kaku-san/PROBE-LX-3/docs/images/social-preview.png

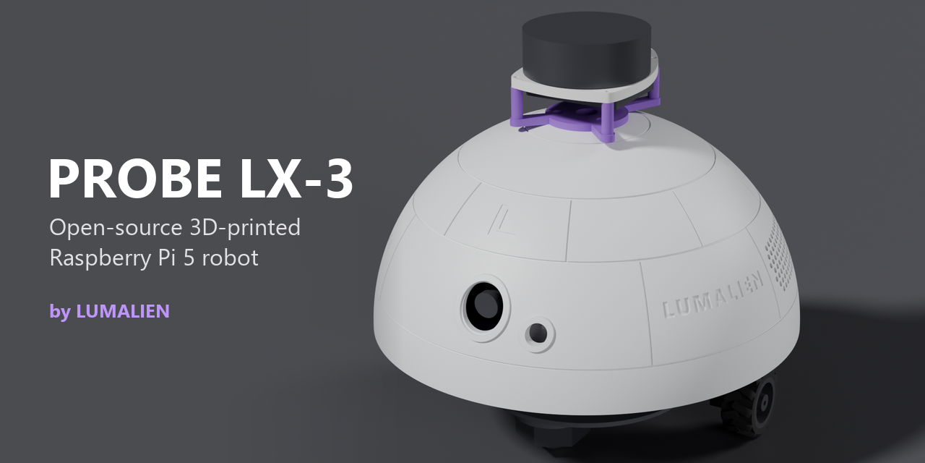
docs/images/social-preview.png
