kaku-san/PROBE-LX-3/hardware/pi5-skid/ROVER_REMAINING_5_PARTS_CHECKED.3mf

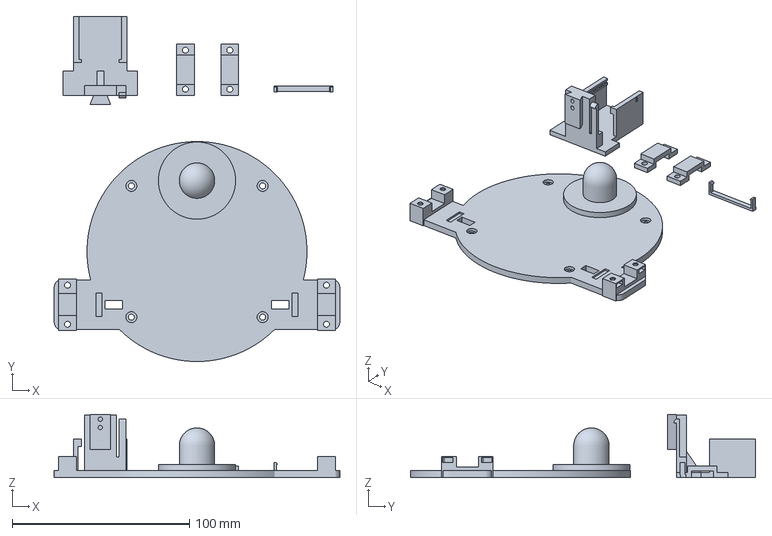
[picture p7: CAD file, 2026-11-10]
hardware/pi5-skid/ROVER_REMAINING_5_PARTS_CHECKED.3mf
161.0 x 194.5 x 35.6 mm
