kaku-san/PROBE-LX-3/hardware/pi5-skid/stl/PROBE-LX3_drive-plate_N20_SKID_CANDIDATE.stl

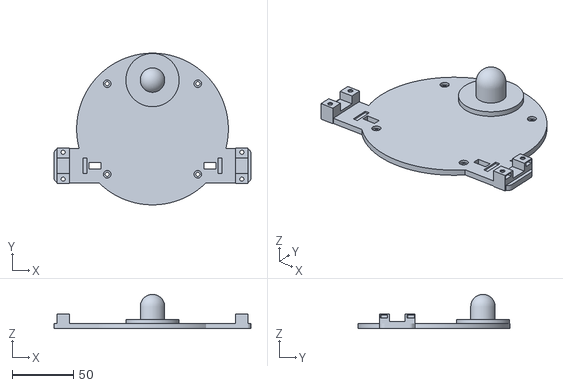
[picture p8: CAD file, 2026-11-10]
hardware/pi5-skid/stl/PROBE-LX3_drive-plate_N20_SKID_CANDIDATE.stl
161.0 x 124.0 x 28.0
