kaku-san/PROBE-LX-3/stl/PROBE-LX3_wheel-hub.stl

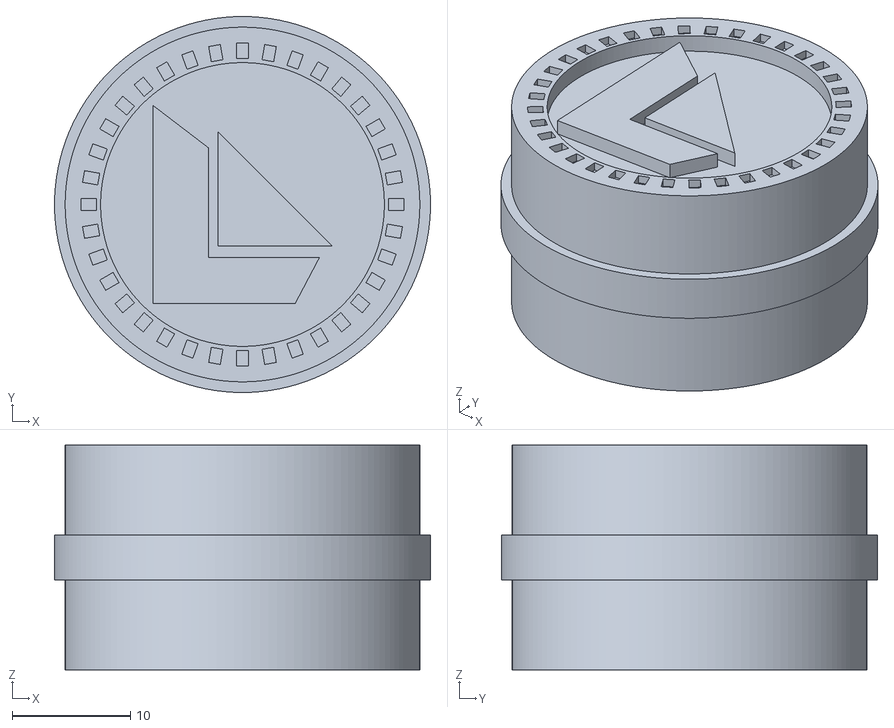
[picture p9: CAD file, 2026-09-24]
stl/PROBE-LX3_wheel-hub.stl
31.8 x 31.8 x 19.0
