kaku-san/PROBE-LX-3/hardware/pi5-skid/stl/N20_CAP_print_two.stl

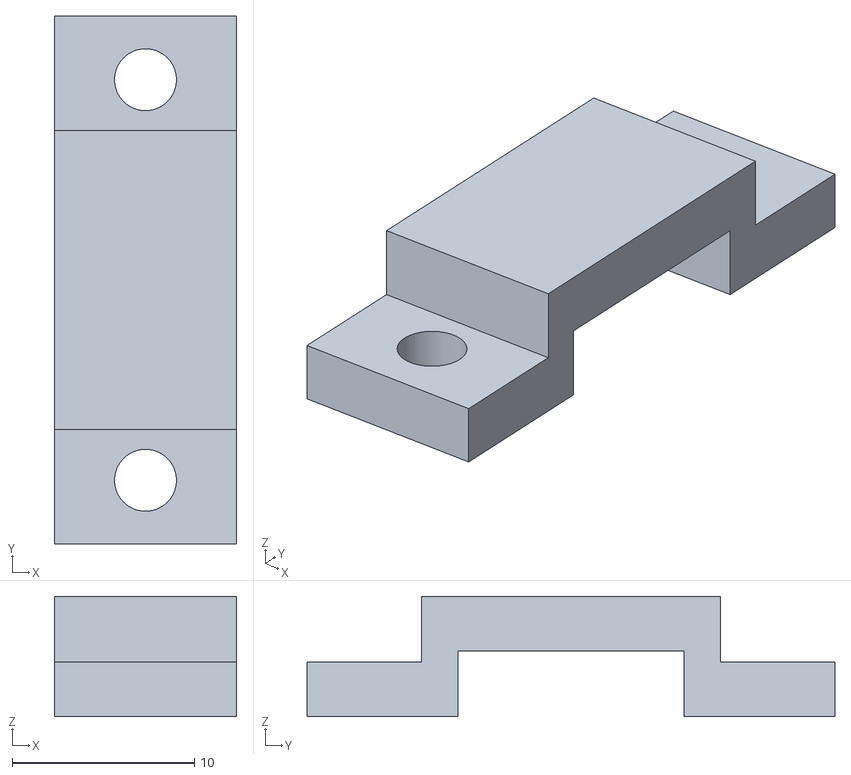
[picture p10: CAD file, 2026-11-10]
hardware/pi5-skid/stl/N20_CAP_print_two.stl
10.0 x 29.0 x 6.60
