kaku-san/PROBE-LX-3/stl/PROBE-LX3_wheel-tyre.stl

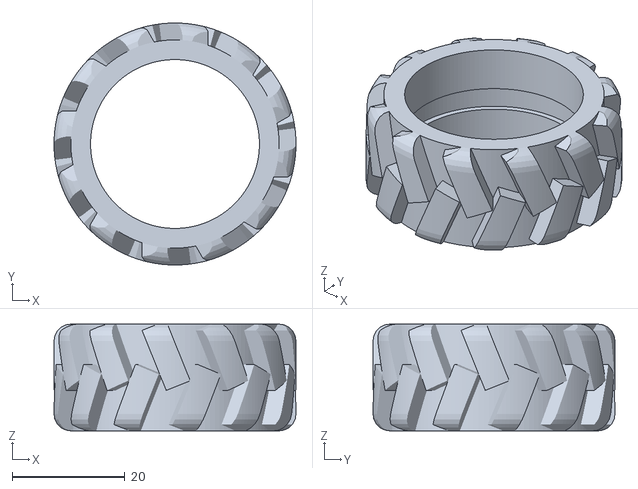
[picture p11: CAD file, 2026-09-24]
stl/PROBE-LX3_wheel-tyre.stl
43.0 x 43.0 x 19.0
