kaku-san/PROBE-LX-3/hardware/pi5-skid/stl/CAMERA_KEEPER_CANDIDATE.stl

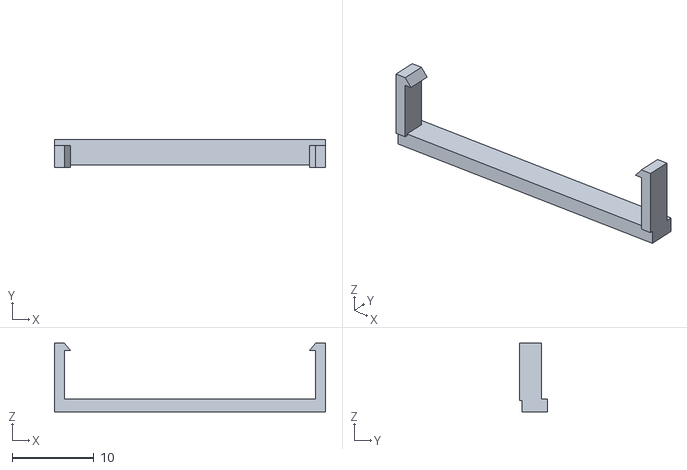
[picture p12: CAD file, 2026-11-10]
hardware/pi5-skid/stl/CAMERA_KEEPER_CANDIDATE.stl
33.1 x 3.40 x 8.40
