kaku-san/PROBE-LX-3/stl/PROBE-LX3_lidar-adapter_optional.stl

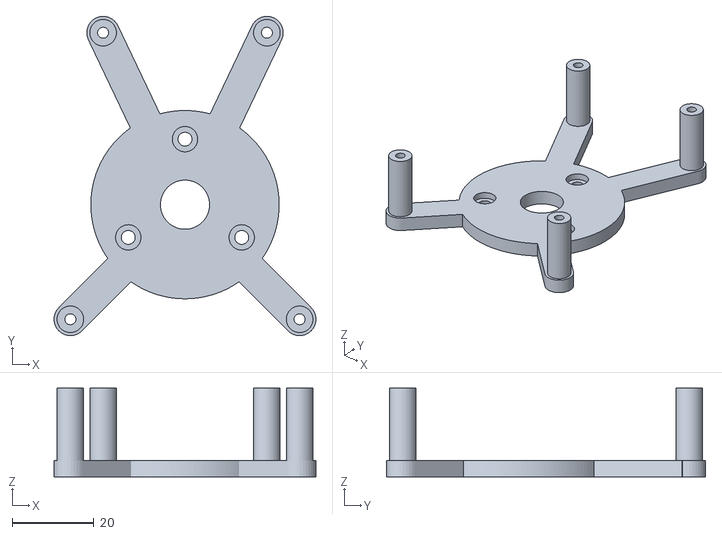
[picture p13: CAD file, 2026-09-24]
stl/PROBE-LX3_lidar-adapter_optional.stl
64.0 x 78.0 x 21.7
