kaku-san/PROBE-LX-3/hardware/pi5-skid/stl/CAMERA_CARRIER_CANDIDATE.stl

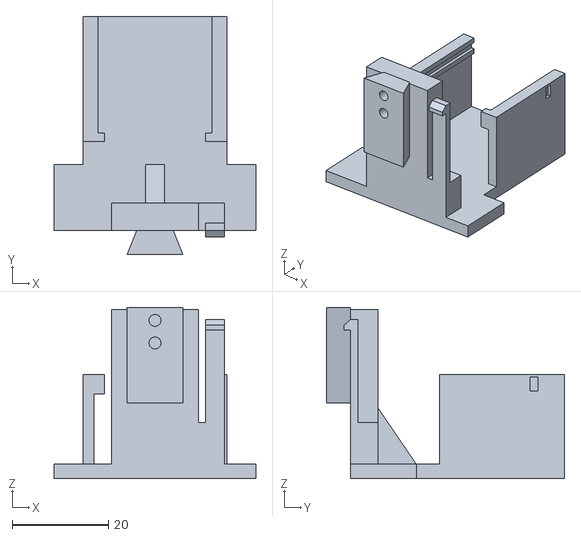
[picture p14: CAD file, 2026-11-10]
hardware/pi5-skid/stl/CAMERA_CARRIER_CANDIDATE.stl
42.0 x 49.5 x 35.6
