kaku-san/PROBE-LX-3/stl/PROBE-LX3_drive-plate.stl

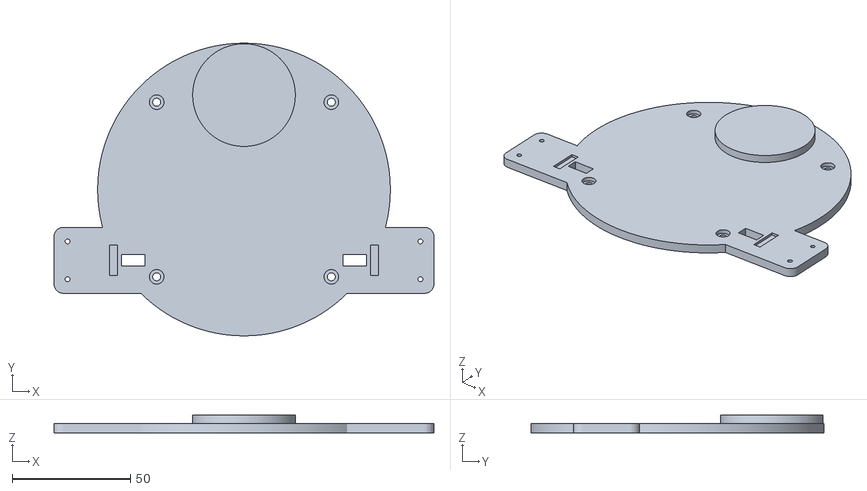
[picture p15: CAD file, 2026-09-24]
stl/PROBE-LX3_drive-plate.stl
161.0 x 124.0 x 7.50
