kaku-san/PROBE-LX-3/stl/PROBE-LX3_electronics-tray.stl

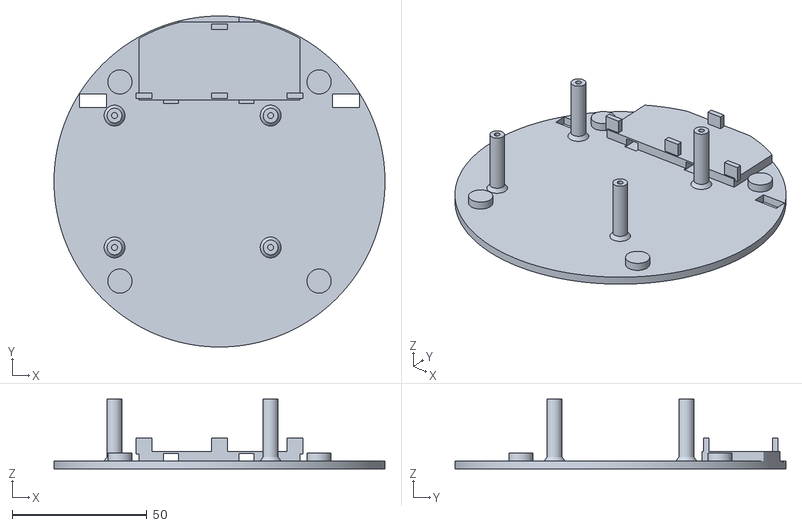
[picture p16: CAD file, 2026-09-24]
stl/PROBE-LX3_electronics-tray.stl
123.0 x 123.0 x 26.0
