kaku-san/PROBE-LX-3/stl/PROBE-LX3_dome.stl

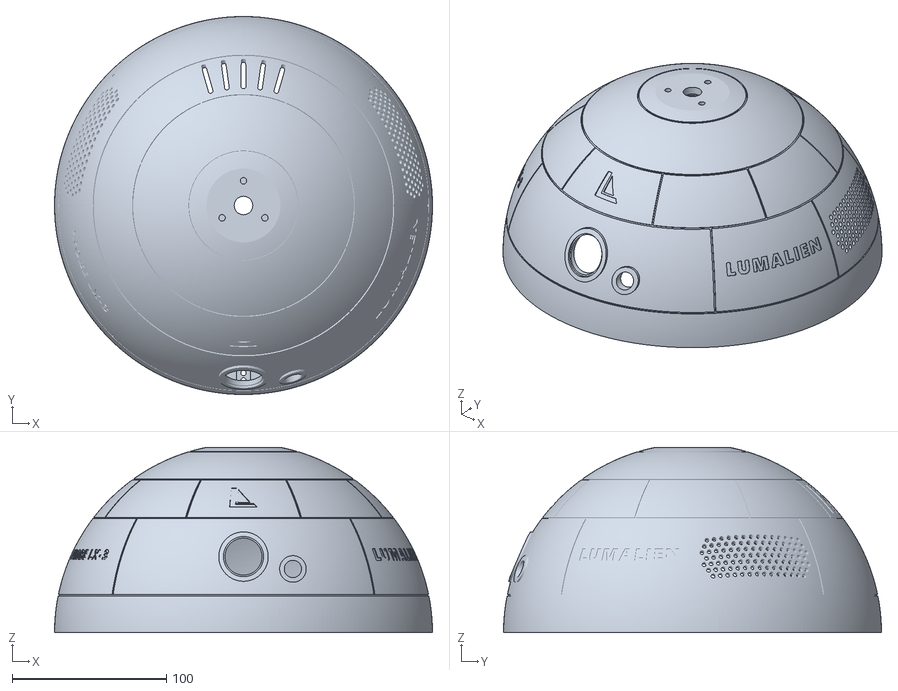
[picture p17: CAD file, 2026-09-24]
stl/PROBE-LX3_dome.stl
244.8 x 244.8 x 120.0
