kaku-san/PROBE-LX-3/stl/PROBE-LX3_base.stl

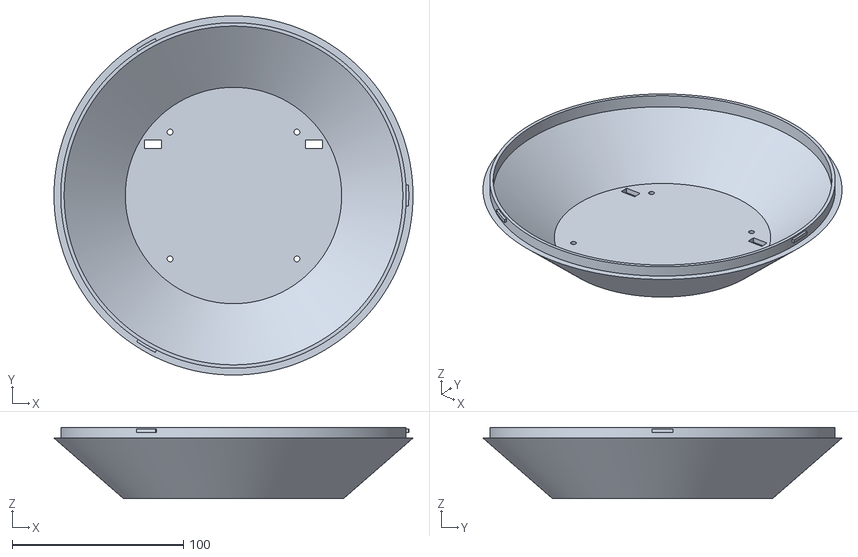
[picture p18: CAD file, 2026-09-24]
stl/PROBE-LX3_base.stl
209.4 x 209.4 x 41.5
