kaku-san/PROBE-LX-3/stl/PROBE-LX3_camera-bracket.stl

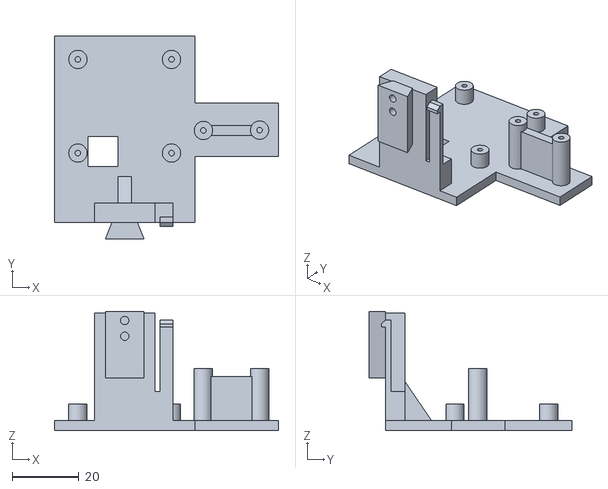
[picture p19: CAD file, 2026-09-24]
stl/PROBE-LX3_camera-bracket.stl
67.0 x 60.7 x 35.6
