kaku-san/PROBE-LX-3/(list of files, cad)

Other CAD files:
cad/PROBE-LX-3.blend
