kaku-san/PROBE-LX-3/docs/build-images/assembly-01-motors.png

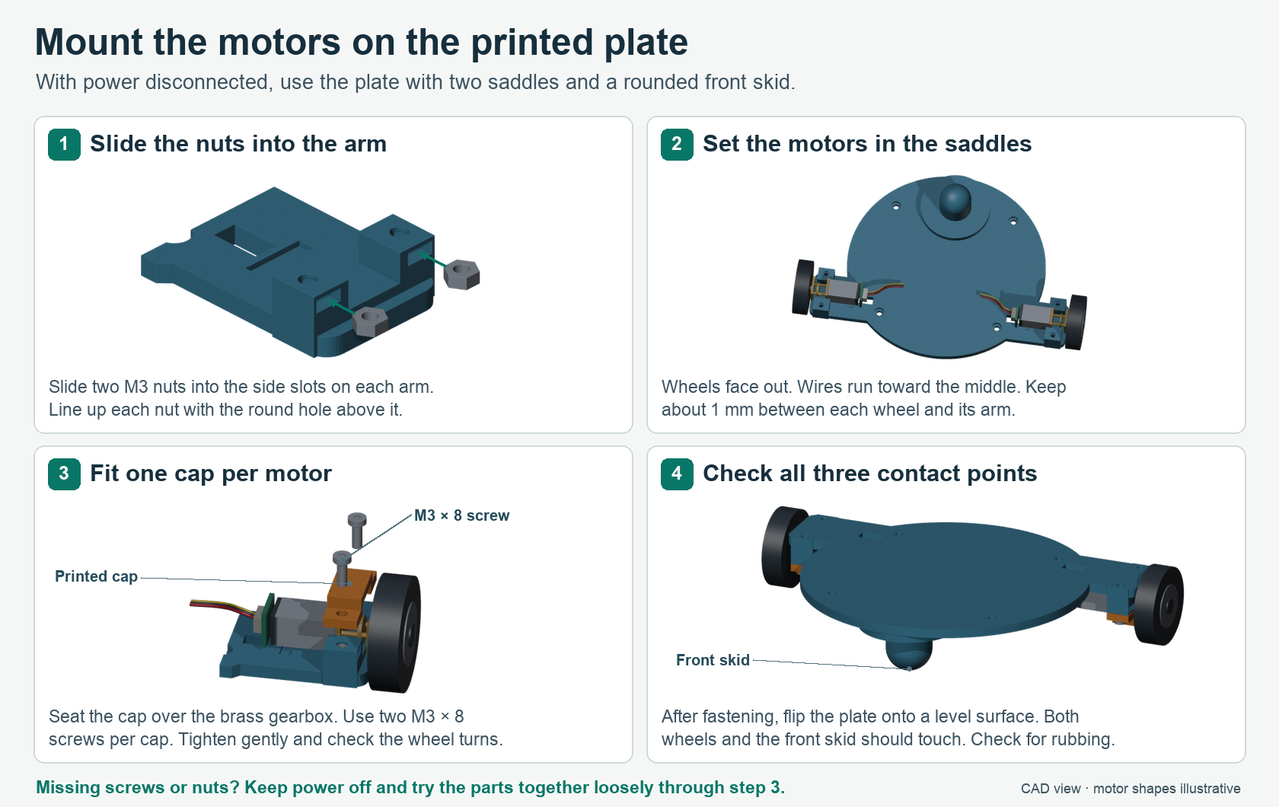
docs/build-images/assembly-01-motors.png
