kaku-san/PROBE-LX-3/docs/build-images/assembly-02-chassis.png

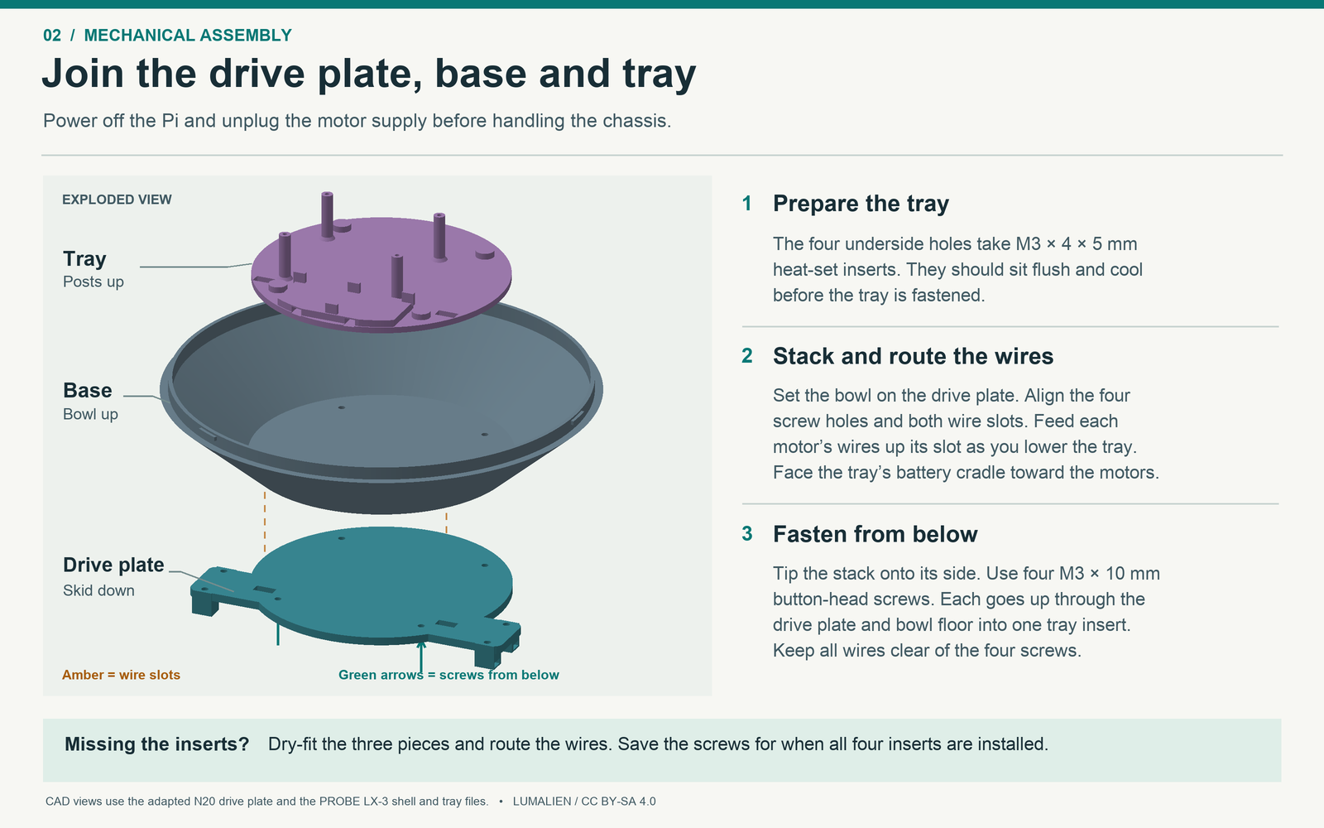
docs/build-images/assembly-02-chassis.png
