kaku-san/PROBE-LX-3/docs/build-images/assembly-03-camera-sensor.png

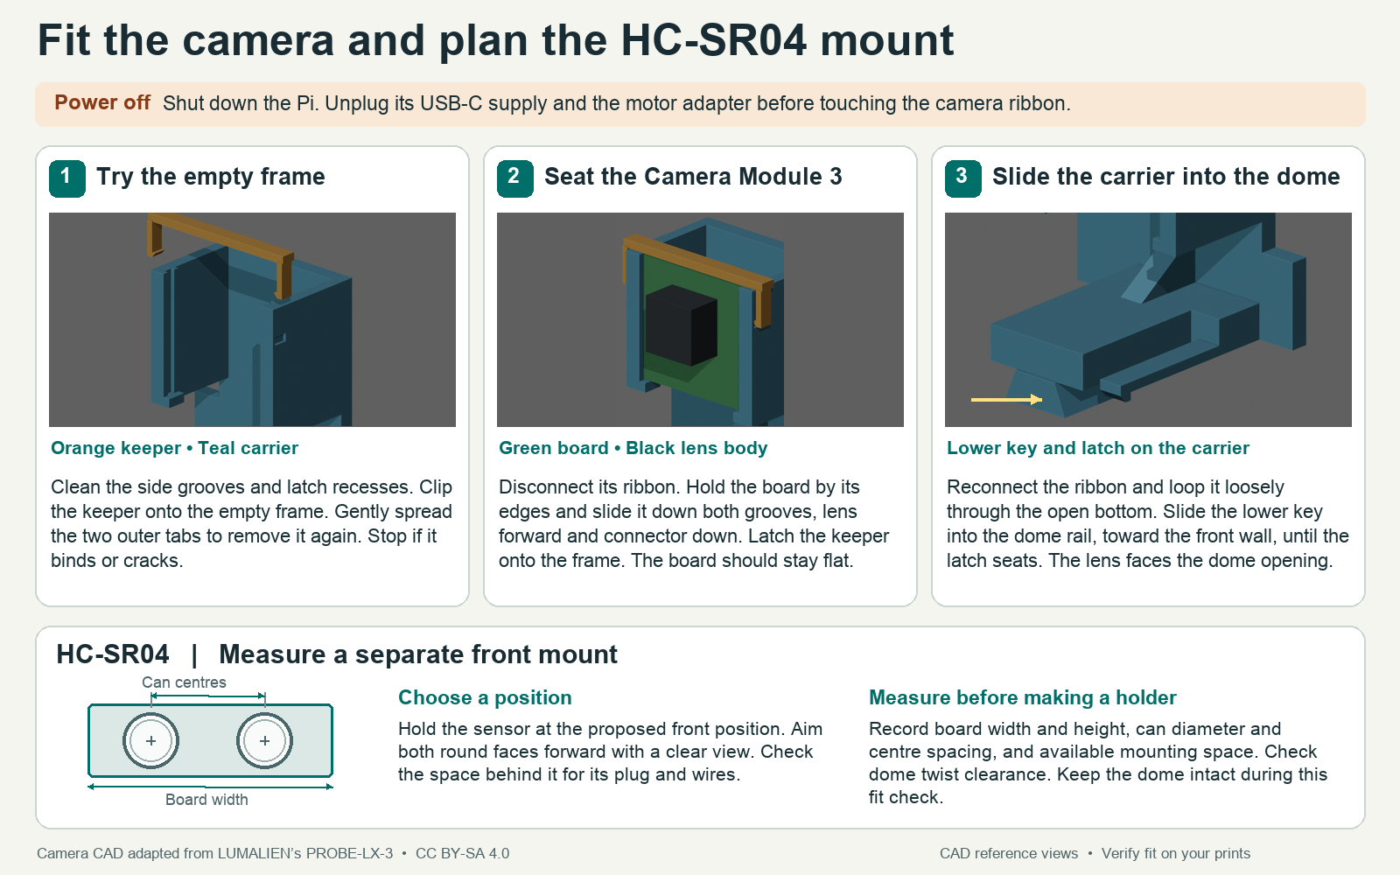
docs/build-images/assembly-03-camera-sensor.png
