kaku-san/PROBE-LX-3/docs/build-images/assembly-04-electronics.png

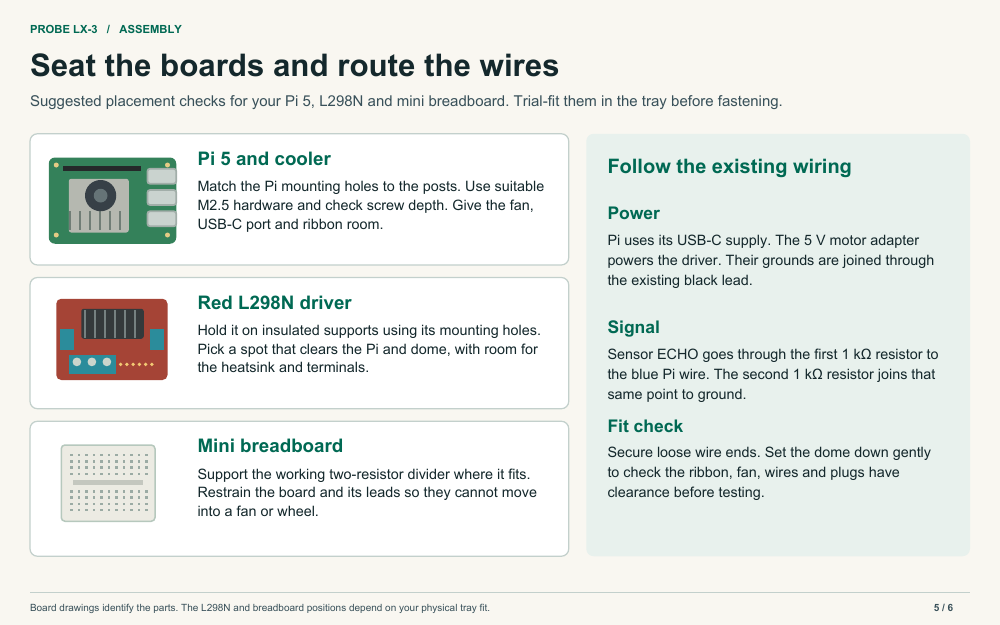
docs/build-images/assembly-04-electronics.png
