kaku-san/PROBE-LX-3/docs/build-images/assembly-05-first-drive.png

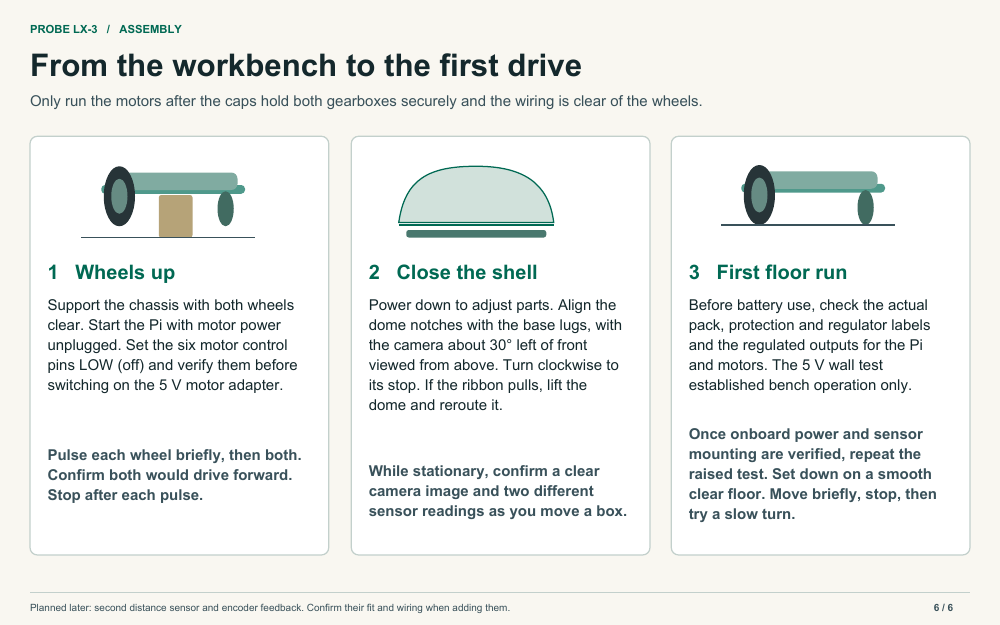
docs/build-images/assembly-05-first-drive.png
