kaku-san/PROBE-LX-3/(commit log)

2026-09-24 Initial release: PROBE LX-3 v2 hardware
    Printable STLs, Blender source model, v2 assembly manual (PDF + MD),
    step-by-step assembly guide, full bill of materials, printing guide,
    wiring/I2C reference, add-on and upgrade notes, and README renders.
    [PROBE-LX-3.blend, PROBE-LX3_base.stl, PROBE-LX3_camera-bracket.stl, PROBE-LX3_dome.stl, PROBE-LX3_drive-plate.stl, PROBE-LX3_electronics-tray.stl, PROBE-LX3_lidar-adapter_optional.stl]
2026-09-24 Add printed wheel hub and TPU tyre; wheel fitting step
    Wheels are printed parts, not supplied with the motors. Adds the hub and
    tyre STLs, a wheel-fitting sub-step in step 4, print/BOM entries, and an
    updated parts render. Drops the caster adhesive cure wait. Regenerates the
    v2 PDF manual. Render script now resolves output paths to absolute.
    [PROBE-LX3_wheel-hub.stl, PROBE-LX3_wheel-tyre.stl]
2026-11-04 Add Pi 5 CLI drive for L298N, HC-SR04, and Camera Module 3 (#1)
    Terminal commands drive the two N20s through gpiozero, pause forward motion
    when the ultrasonic reading is too close, and save a Camera Module 3 still.
    Hardware docs and STLs are unchanged.
    [camera.py, capture.py, check_distance.py, check_env.py, controller.py, drive.py, fakes.py, motor_test.py]
2026-11-10 Handover for the bench-tested Pi 5 rover and adapted prints (#2)
    [CAMERA_CARRIER_CANDIDATE.stl, CAMERA_KEEPER_CANDIDATE.stl, N20_CAP_print_two.stl, PROBE-LX3_drive-plate_N20_SKID_CANDIDATE.stl, ROVER_REMAINING_5_PARTS_CHECKED.3mf]
